slimskism/steamsplit/Cases/readme.md

This folder contains various 3D printable case files. Mirror to get the right hand side.
