slimskism/steamsplit/KiCadFiles/LHS/production/bom.csv

Designator | Footprint | Quantity | Value | LCSC Part #
D1, D10, D11, D12, D13, D14, D15, D16, D17, D18, D19, D2, D20, D21, D22, D23, D24, D3, D4, D5, D6, D8, D9 | Diode_DO-35 | 23 | Diode
J1 | IDC-Header_2x08_P2.54mm_Vertical | 1 | Conn_02x08_Top_Bottom
J2 | PinHeader_1x04_P2.54mm_Vertical | 1 | Conn_01x04
S1, S10, S11, S12, S13, S14, S15, S16, S17, S18, S19, S2, S20, S21, S22, S23, S24, S3, S4, S5, S6, S8, S9 | Hotswap_MX | 23 | Keyswitch
