slimskism/steamsplit/Cases/MacroPadCaseMk1.stl

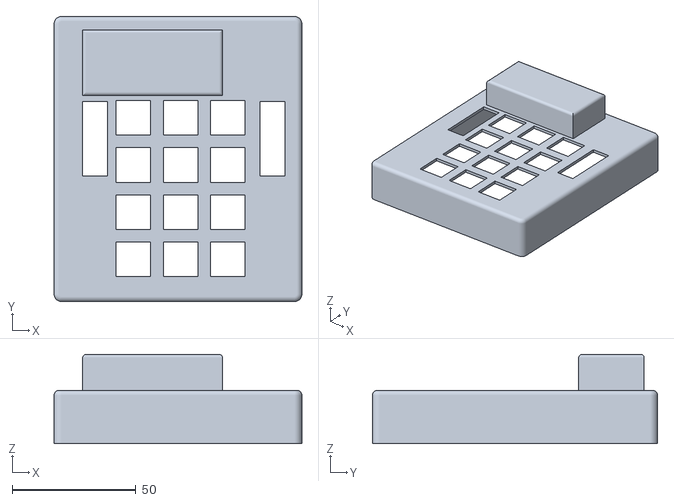
[picture p2: CAD file, 2026-10-19]
Cases/MacroPadCaseMk1.stl
100.0 x 115.0 x 36.0
