slimskism/steamsplit/Cases/CaseMk3-Body.stl

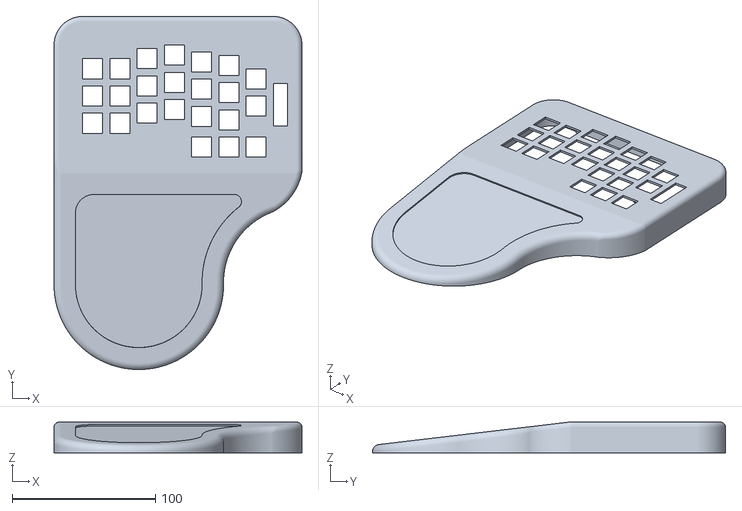
[picture p3: CAD file, 2026-10-19]
Cases/CaseMk3-Body.stl
173.3 x 246.7 x 21.5
