slimskism/steamsplit/Cases/CaseMk3Basic-Body.stl

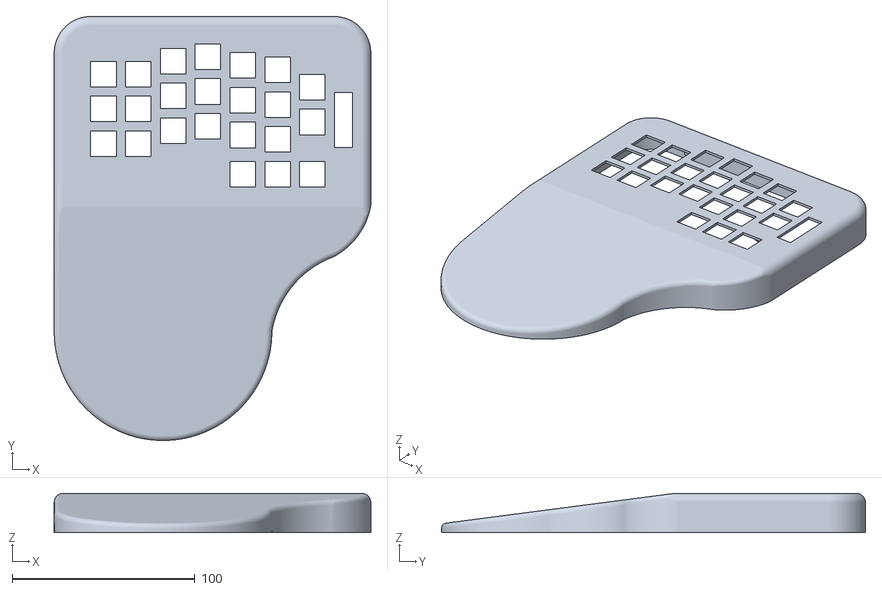
[picture p4: CAD file, 2026-10-19]
Cases/CaseMk3Basic-Body.stl
173.3 x 232.0 x 21.5
