slimskism/steamsplit/KiCadFiles/NumPad/SweepMinPi.kicad_pcb

## KiCad design KiCadFiles/NumPad/SweepMinPi.kicad_pcb (2026-10-22)

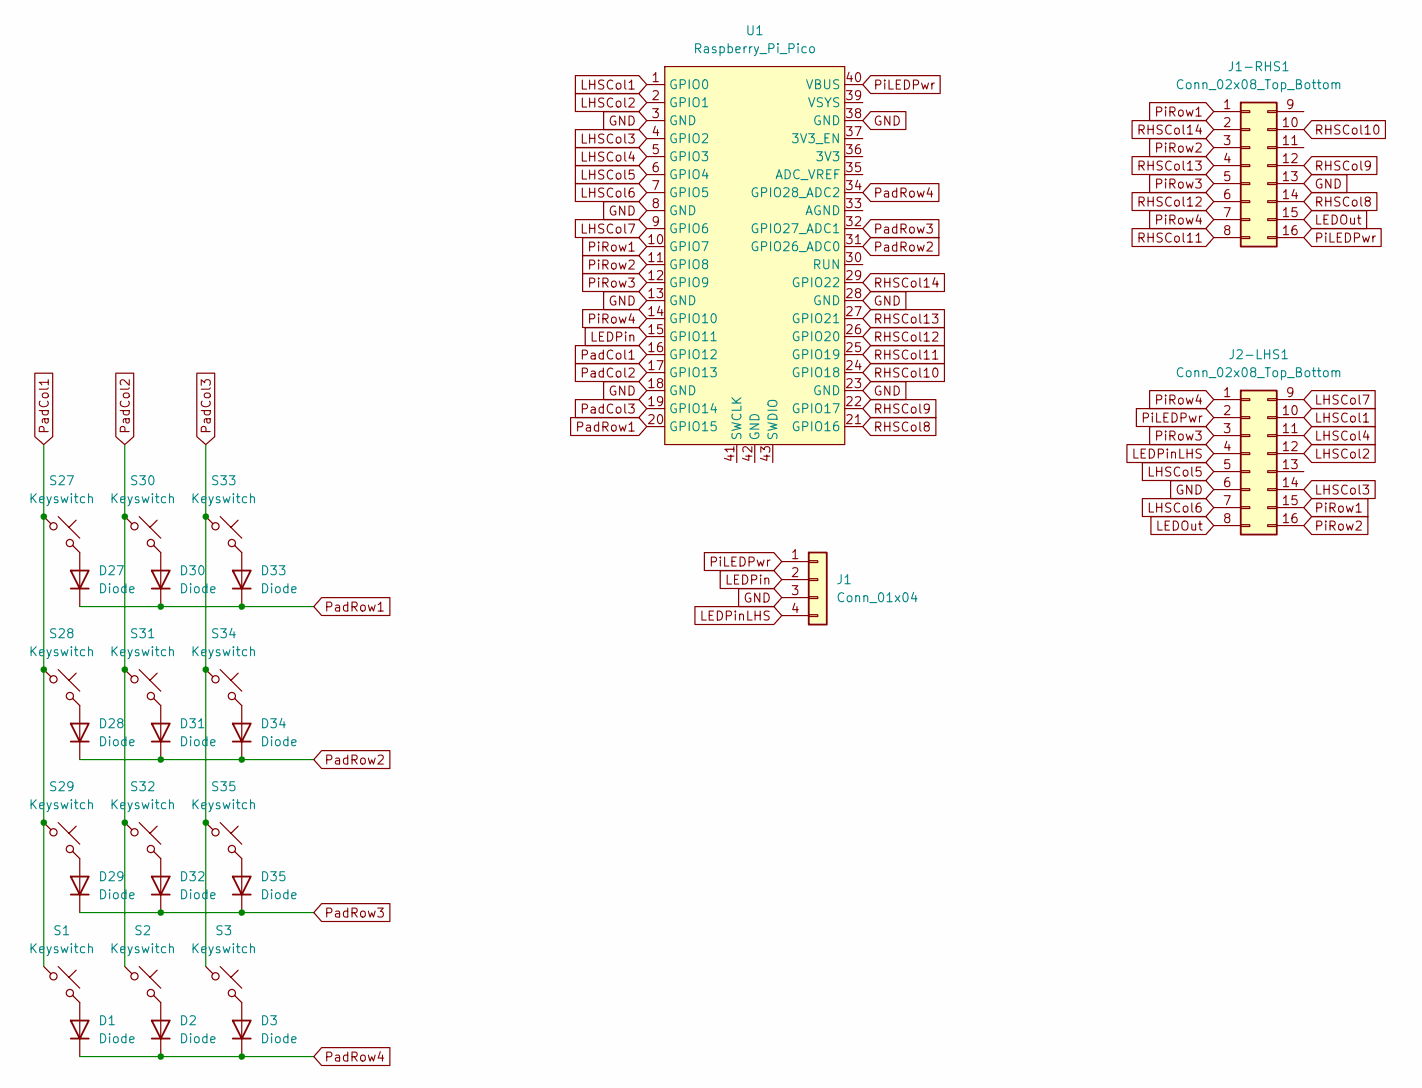
[picture p5: schematic SweepMinPi.kicad_sch]

Parts:
D1, D2, D3, D27, D28, D29, D30, D31, D32, D33, D34, D35: Diode; Diode_DO-35
J1: Conn_01x04; PinHeader_1x04_P2.54mm_Vertical
J1-RHS1, J2-LHS1: Conn_02x08_Top_Bottom; IDC-Header_2x08_P2.54mm_Vertical
S1, S2, S3, S27, S28, S29, S30, S31, S32, S33, S34, S35: Keyswitch; Hotswap_MX
U1: Raspberry_Pi_Pico

Connections:
GND: J1.3, J1-RHS1.13, J2-LHS1.6, U1.3 (GND), U1.8 (GND), U1.13 (GND), U1.18 (GND), U1.23 (GND), U1.28 (GND), U1.38 (GND)
LEDOut: J1-RHS1.15, J2-LHS1.8
LEDPin: J1.2, U1.15 (GPIO11)
LEDPinLHS: J1.4, J2-LHS1.4
LHSCol1: J2-LHS1.10, U1.1 (GPIO0)
LHSCol2: J2-LHS1.12, U1.2 (GPIO1)
LHSCol3: J2-LHS1.14, U1.4 (GPIO2)
LHSCol4: J2-LHS1.11, U1.5 (GPIO3)
LHSCol5: J2-LHS1.5, U1.6 (GPIO4)
LHSCol6: J2-LHS1.7, U1.7 (GPIO5)
LHSCol7: J2-LHS1.9, U1.9 (GPIO6)
unnamed: D1.2 (A), S1.2
unnamed: D2.2 (A), S2.2
unnamed: D3.2 (A), S3.2
unnamed: D27.2 (A), S27.2
unnamed: D28.2 (A), S28.2
unnamed: D29.2 (A), S29.2
unnamed: D30.2 (A), S30.2
unnamed: D31.2 (A), S31.2
unnamed: D32.2 (A), S32.2
unnamed: D33.2 (A), S33.2
unnamed: D34.2 (A), S34.2
unnamed: D35.2 (A), S35.2
PadCol1: S1.1, S27.1, S28.1, S29.1, U1.16 (GPIO12)
PadCol2: S2.1, S30.1, S31.1, S32.1, U1.17 (GPIO13)
PadCol3: S3.1, S33.1, S34.1, S35.1, U1.19 (GPIO14)
PadRow1: D27.1 (K), D30.1 (K), D33.1 (K), U1.20 (GPIO15)
PadRow2: D28.1 (K), D31.1 (K), D34.1 (K), U1.31 (GPIO26_ADC0)
PadRow3: D29.1 (K), D32.1 (K), D35.1 (K), U1.32 (GPIO27_ADC1)
PadRow4: D1.1 (K), D2.1 (K), D3.1 (K), U1.34 (GPIO28_ADC2)
PiLEDPwr: J1.1, J1-RHS1.16, J2-LHS1.2, U1.40 (VBUS)
PiRow1: J1-RHS1.1, J2-LHS1.15, U1.10 (GPIO7)
PiRow2: J1-RHS1.3, J2-LHS1.16, U1.11 (GPIO8)
PiRow3: J1-RHS1.5, J2-LHS1.3, U1.12 (GPIO9)
PiRow4: J1-RHS1.7, J2-LHS1.1, U1.14 (GPIO10)
RHSCol8: J1-RHS1.14, U1.21 (GPIO16)
RHSCol9: J1-RHS1.12, U1.22 (GPIO17)
RHSCol10: J1-RHS1.10, U1.24 (GPIO18)
RHSCol11: J1-RHS1.8, U1.25 (GPIO19)
RHSCol12: J1-RHS1.6, U1.26 (GPIO20)
RHSCol13: J1-RHS1.4, U1.27 (GPIO21)
RHSCol14: J1-RHS1.2, U1.29 (GPIO22)

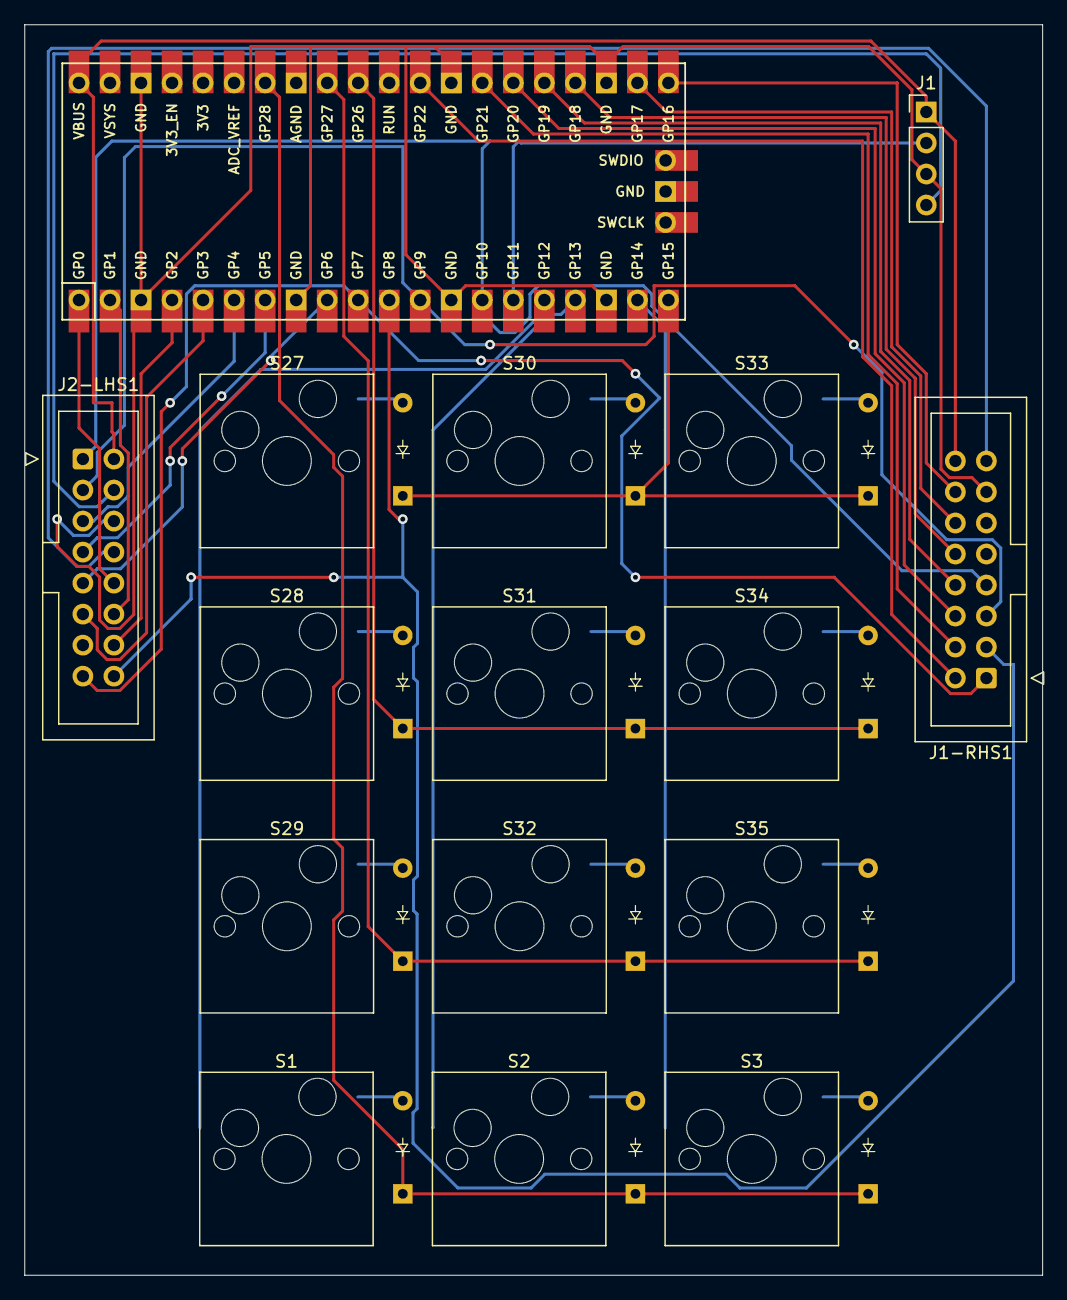
[picture p6: board SweepMinPi.kicad_pcb from above]

Board: 2 copper layers, 83.3 x 102.4 mm, 28 parts (0 on the bottom side), 42 nets.
