slimskism/steamsplit/KiCadFiles/RHS/SweepMinRHS.kicad_pcb

## KiCad design KiCadFiles/RHS/SweepMinRHS.kicad_pcb (2026-10-22)

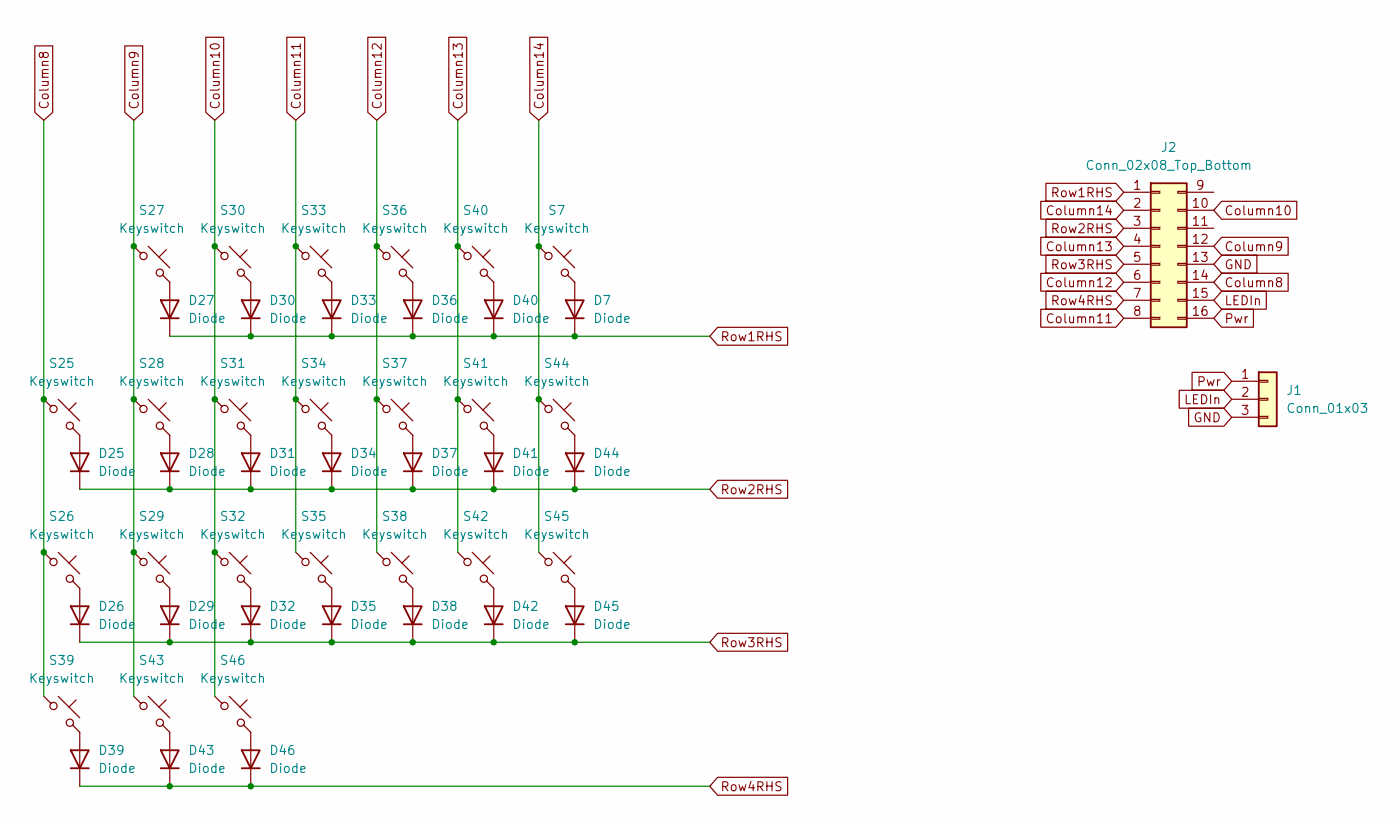
[picture p7: schematic SweepMinRHS.kicad_sch]

Parts:
D7, D25, D26, D27, D28, D29, D30, D31, D32, D33, D34, D35, D36, D37, D38, D39, D40, D41, D42, D43, D44, D45, D46: Diode; Diode_DO-35
J1: Conn_01x03; PinHeader_1x03_P2.54mm_Vertical
J2: Conn_02x08_Top_Bottom; IDC-Header_2x08_P2.54mm_Vertical
S7, S25, S26, S27, S28, S29, S30, S31, S32, S33, S34, S35, S36, S37, S38, S39, S40, S41, S42, S43, S44, S45, S46: Keyswitch; Hotswap_MX

Connections:
Column8: J2.14, S25.1, S26.1, S39.1
Column9: J2.12, S27.1, S28.1, S29.1, S43.1
Column10: J2.10, S30.1, S31.1, S32.1, S46.1
Column11: J2.8, S33.1, S34.1, S35.1
Column12: J2.6, S36.1, S37.1, S38.1
Column13: J2.4, S40.1, S41.1, S42.1
Column14: J2.2, S7.1, S44.1, S45.1
GND: J1.3, J2.13
LEDIn: J1.2, J2.15
unnamed: D7.2 (A), S7.2
unnamed: D25.2 (A), S25.2
unnamed: D26.2 (A), S26.2
unnamed: D27.2 (A), S27.2
unnamed: D28.2 (A), S28.2
unnamed: D29.2 (A), S29.2
unnamed: D30.2 (A), S30.2
unnamed: D31.2 (A), S31.2
unnamed: D32.2 (A), S32.2
unnamed: D33.2 (A), S33.2
unnamed: D34.2 (A), S34.2
unnamed: D35.2 (A), S35.2
unnamed: D36.2 (A), S36.2
unnamed: D37.2 (A), S37.2
unnamed: D38.2 (A), S38.2
unnamed: D39.2 (A), S39.2
unnamed: D40.2 (A), S40.2
unnamed: D41.2 (A), S41.2
unnamed: D42.2 (A), S42.2
unnamed: D43.2 (A), S43.2
unnamed: D44.2 (A), S44.2
unnamed: D45.2 (A), S45.2
unnamed: D46.2 (A), S46.2
Pwr: J1.1, J2.16
Row1RHS: D7.1 (K), D27.1 (K), D30.1 (K), D33.1 (K), D36.1 (K), D40.1 (K), J2.1
Row2RHS: D25.1 (K), D28.1 (K), D31.1 (K), D34.1 (K), D37.1 (K), D41.1 (K), D44.1 (K), J2.3
Row3RHS: D26.1 (K), D29.1 (K), D32.1 (K), D35.1 (K), D38.1 (K), D42.1 (K), D45.1 (K), J2.5
Row4RHS: D39.1 (K), D43.1 (K), D46.1 (K), J2.7

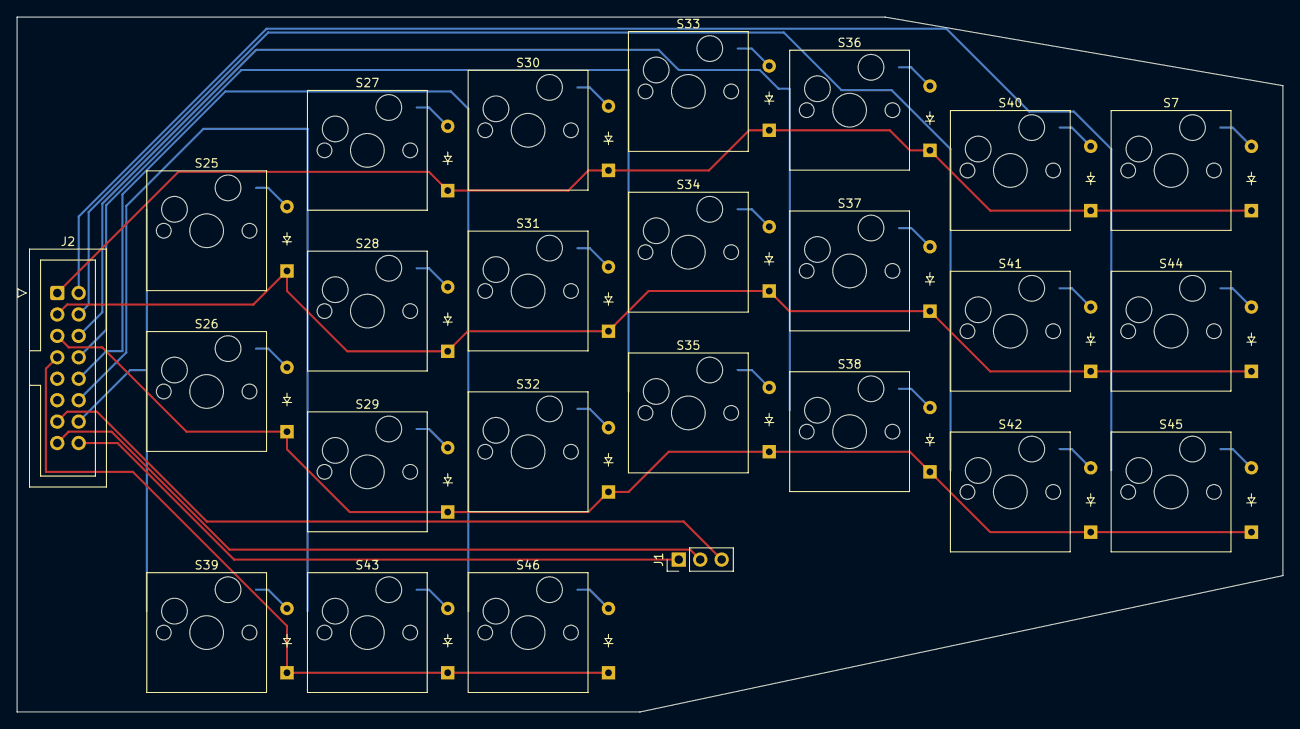
[picture p8: board SweepMinRHS.kicad_pcb from above]

Board: 2 copper layers, 150.0 x 82.4 mm, 48 parts (0 on the bottom side), 37 nets.
